mpkendall/RXBox/hardware/rxbox/sbc-power.kicad_sch

## KiCad design hardware/rxbox/sbc-power.kicad_sch (2026-09-08, an earlier design)

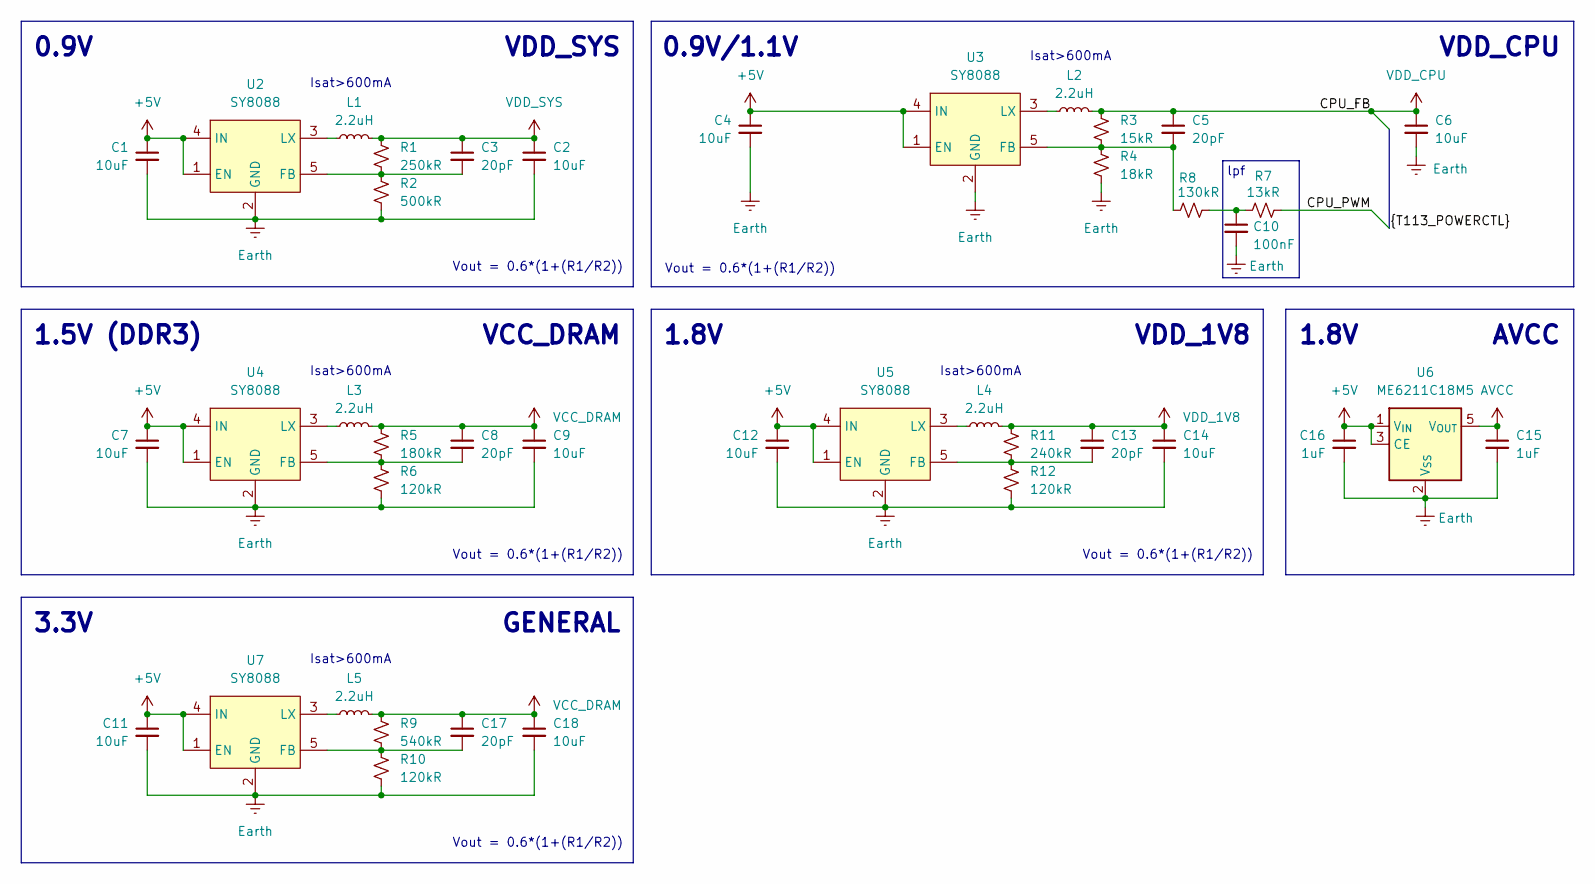
[picture p1: schematic sbc-power.kicad_sch]

Parts:
C1, C2, C4, C6, C7, C9, C11, C12, C14, C18: 10uF; C_0402_1005Metric
C3, C5, C8, C13, C17: 20pF; C_0402_1005Metric
C10: 100nF; C_0402_1005Metric
C15, C16: 1uF; C_0402_1005Metric
L1, L2, L3, L4, L5: 2.2uH
R1: 250kR; R_0402_1005Metric
R2: 500kR; R_0402_1005Metric
R3: 15kR; R_0402_1005Metric
R4: 18kR; R_0402_1005Metric
R5: 180kR; R_0402_1005Metric
R6, R10, R12: 120kR; R_0402_1005Metric
R7: 13kR; R_0402_1005Metric
R8: 130kR; R_0402_1005Metric
R9: 540kR; R_0402_1005Metric
R11: 240kR; R_0402_1005Metric
U2, U3, U4, U5, U7: SY8088; SOT-23-5
U6: ME6211C18M5; SOT-23-5

Connections:
+5V: C1.1, C4.1, C7.1, C11.1, C12.1, C16.1, U2.1 (EN), U2.4 (IN), U3.1 (EN), U3.4 (IN), U4.1 (EN), U4.4 (IN), U5.1 (EN), U5.4 (IN), U6.1 (V_{IN}), U6.3 (CE), U7.1 (EN), U7.4 (IN)
AVCC: C15.1, U6.5 (V_{OUT})
CPU_PWM: R7.2
Earth: C1.2, C2.2, C4.2, C6.2, C7.2, C9.2, C10.2, C11.2, C12.2, C14.2, C15.2, C16.2, C18.2, R2.2, R4.2, R6.2, R10.2, R12.2, U2.2 (GND), U3.2 (GND), U4.2 (GND), U5.2 (GND), U6.2 (V_{SS}), U7.2 (GND)
unnamed: C3.2, R1.2, R2.1, U2.5 (FB)
unnamed: C5.2, R3.2, R4.1, R8.1, U3.5 (FB)
unnamed: C8.2, R5.2, R6.1, U4.5 (FB)
unnamed: C10.1, R7.1, R8.2
unnamed: C13.2, R11.2, R12.1, U5.5 (FB)
unnamed: C17.2, R9.2, R10.1, U7.5 (FB)
unnamed: L1.1, U2.3 (LX)
unnamed: L2.1, U3.3 (LX)
unnamed: L3.1, U4.3 (LX)
unnamed: L4.1, U5.3 (LX)
unnamed: L5.1, U7.3 (LX)
VCC_DRAM: C8.1, C9.1, C17.1, C18.1, L3.2, L5.2, R5.1, R9.1
VDD_1V8: C13.1, C14.1, L4.2, R11.1
VDD_CPU: C5.1, C6.1, L2.2, R3.1
VDD_SYS: C2.1, C3.1, L1.2, R1.1

Notes on the sheet:
Isat>600mA
Vout = 0.6*(1+(R1/R2))
VDD_CPU
VDD_1V8
0.9V/1.1V
1.8V
lpf
VDD_SYS
1.5V (DDR3)
0.9V
AVCC
3.3V
VCC_DRAM
GENERAL
