mpkendall/RXBox/hardware/rxbox/storage.kicad_sch

## KiCad design hardware/rxbox/storage.kicad_sch (2026-09-10, an earlier design)

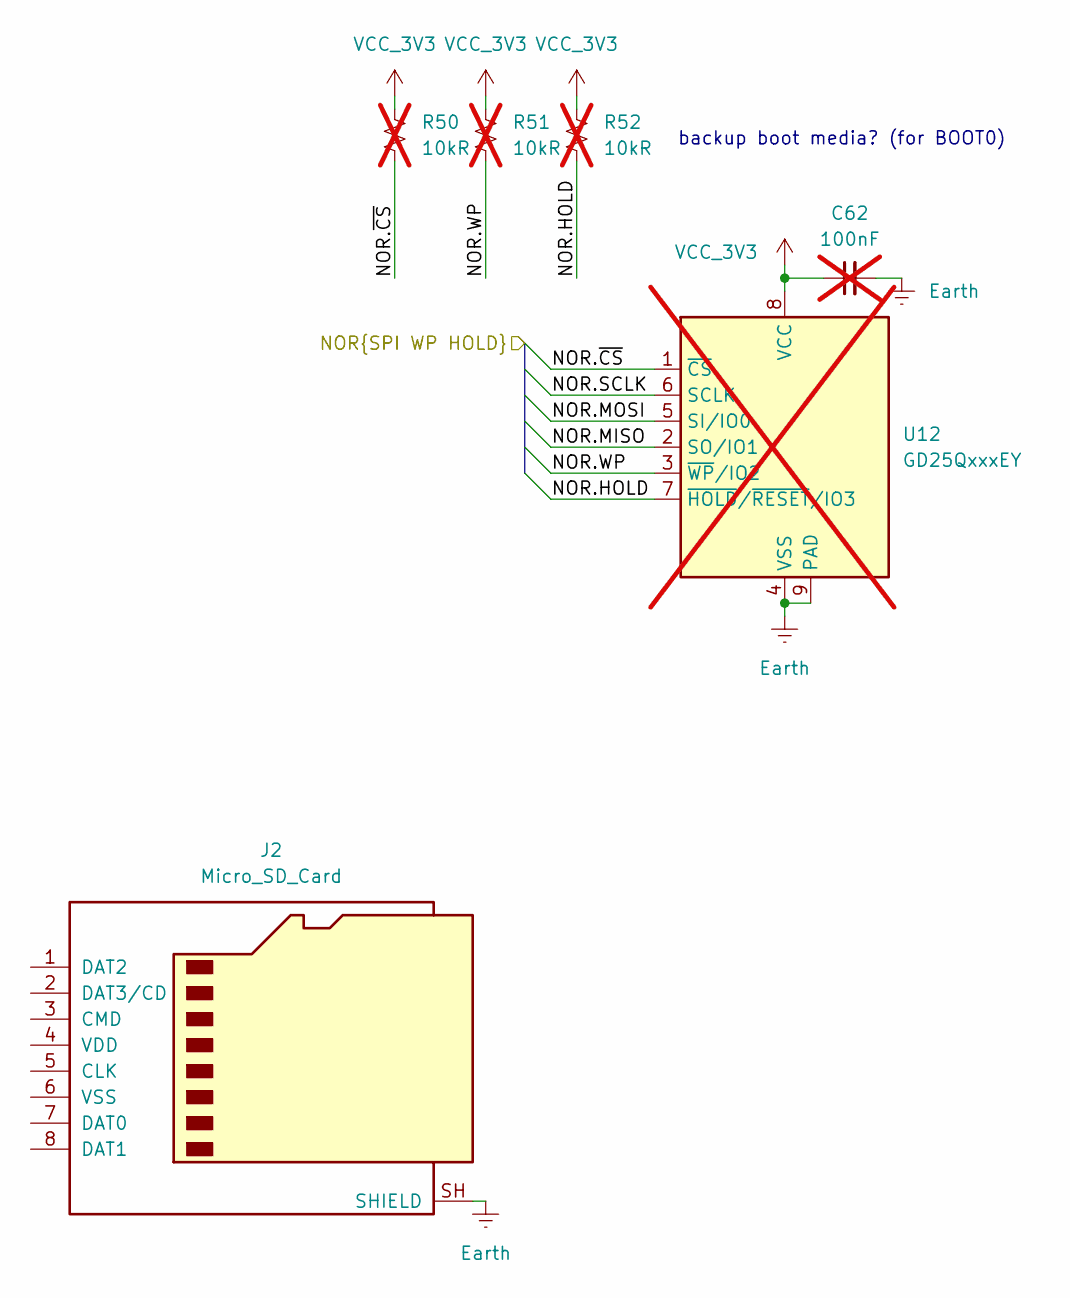
[picture p2: schematic storage.kicad_sch]

Parts:
C62: 100nF; not fitted
J2: Micro_SD_Card; microSD_HC_Wuerth_693072010801
R50, R51, R52: 10kR; not fitted
U12: GD25QxxxEY; WSON-8-1EP_8x6mm_P1.27mm_EP3.4x4.3mm; not fitted

Connections:
Earth: C62.2, J2.SH (SHIELD), U12.4 (VSS), U12.9 (PAD)
NOR.HOLD: R52.1, U12.7 (~HOLD/~RESET/IO3)
NOR.MISO: U12.2 (SO/IO1)
NOR.MOSI: U12.5 (SI/IO0)
NOR.SCLK: U12.6 (SCLK)
NOR.WP: R51.1, U12.3 (~WP/IO2)
NOR.~CS: R50.1, U12.1 (~CS)
VCC_3V3: C62.1, R50.2, R51.2, R52.2, U12.8 (VCC)

Notes on the sheet:
backup boot media? (for BOOT0)
