mpkendall/RXBox/(commit log)

2025-11-23 started routing
    [RXBox.kicad_pcb]
2026-01-25 revive project
    [RXBox.kicad_pcb, RXBox.kicad_sch]
2026-01-26 done sdr?!
    [RXBox.kicad_pcb, RXBox.kicad_sch]
2026-02-15 lowkey forgot git exists
    [RXBox.kicad_pcb, RXBox.kicad_sch]
2026-03-22 starting to add stuff
    [RXBox.kicad_pcb, RXBox.kicad_sch]
2026-06-26 push current version
    [bom.csv, computemodule.kicad_sch, designators.csv, interface.kicad_sch, positions.csv, power.kicad_sch, screen.kicad_sch, sdr.kicad_sch]
2026-06-26 starting over fresh!
    [RXBox.kicad_pcb, RXBox.kicad_sch, bom.csv, computemodule.kicad_sch, designators.csv, interface.kicad_sch, positions.csv, power.kicad_sch]
2026-06-28 first batch of power
    [rxbox.kicad_pcb, rxbox.kicad_sch, sbc-power.kicad_sch, sbc.kicad_sch, t113.kicad_sch]
2026-06-29 finish up journal
    [sbc-power.kicad_sch, sbc-sequencing.kicad_sch]
2026-07-01 add custom kicad libraries
2026-07-01 supervisor + symbol, new journal. jumper for t113 power
    [dev.kicad_sch, rxbox.kicad_sch, sbc-power.kicad_sch, sbc-sequencing.kicad_sch]
2026-07-01 connect power + t113 sheets
    [dev.kicad_sch, sbc-power.kicad_sch, sbc-sequencing.kicad_sch, sbc.kicad_sch, t113.kicad_sch]
2026-07-05 finish up power, start wifi
    [dev.kicad_sch, sbc-sequencing.kicad_sch, sbc.kicad_sch, t113.kicad_sch, wifi.kicad_sch]
2026-07-06 sdio bus + new wifi module
    [sbc.kicad_sch, wifi.kicad_sch]
2026-07-11 wifi updates
    [sbc-power.kicad_sch, sbc.kicad_sch, wifi.kicad_sch]
2026-07-18 wiring wifi + bt to t113
    [dev.kicad_sch, sbc-power.kicad_sch, sbc.kicad_sch, t113.kicad_sch, wifi.kicad_sch]
2026-09-08 finish hooking up wifi+bt, and power
    [sbc-power.kicad_sch, sbc-sequencing.kicad_sch, sbc.kicad_sch, t113.kicad_sch, wifi.kicad_sch]
2026-09-08 start ddr3
    [ddr3.kicad_sch]
2026-09-08 start boot media circuitry
    [sbc.kicad_sch, storage.kicad_sch, t113.kicad_sch]
2026-09-10 draft of ddr circuitry
    [ddr3.kicad_sch, sbc.kicad_sch, storage.kicad_sch, t113.kicad_sch]
